open-aiq/hardware/pcb/proto2/fab/proto2-bom.csv

Reference | Value | Part | Footprint | Qty | Datasheet
C1 | 100uF | 100 µF electrolytic, ≥10 V, 6.3 mm radial, 2.5 mm pitch | Capacitor_THT:CP_Radial_D6.3mm_P2.50mm | 1
C2,C4 | 100nF | 100 nF ceramic, 5 mm pitch | Capacitor_THT:C_Disc_D5.0mm_W2.5mm_P5.00mm | 2
C3 | 10uF | 10 µF electrolytic, ≥10 V, 5 mm radial, 2 mm pitch | Capacitor_THT:CP_Radial_D5.0mm_P2.00mm | 1
J1 | PMS5003 | Molex PicoBlade 53047-0810, 8-pin 1.25 mm vertical header | Connector_Molex:Molex_PicoBlade_53047-0810_1x08_P1.25mm_Vertical | 1
J2 | OLED_SH1106 | 1×4 female header, 2.54 mm, for a 1.3 in SH1106 128×64 I2C OLED module | Connector_PinSocket_2.54mm:PinSocket_1x04_P2.54mm_Vertical | 1
J3 | SHT30 | 1×4 + 1×2 female header, 2.54 mm, for an SHT30 breakout (4 + 2 pins) | open-aiq:SHT30_Module_Socket_4+2 | 1
R1,R2 | 4.7k | 4.7 kΩ resistor, 1/4 W axial | Resistor_THT:R_Axial_DIN0207_L6.3mm_D2.5mm_P10.16mm_Horizontal | 2
R3,R4 | 10k | 10 kΩ resistor, 1/4 W axial | Resistor_THT:R_Axial_DIN0207_L6.3mm_D2.5mm_P10.16mm_Horizontal | 2
SW1 | Right | 6×6 mm THT tactile switch, 4-leg (e.g. Omron B3F-1000) | Button_Switch_THT:SW_PUSH_6mm | 1
SW2 | Left | 6×6 mm THT tactile switch, 4-leg (e.g. Omron B3F-1000) | Button_Switch_THT:SW_PUSH_6mm | 1
SW3 | Pair | 6×6 mm THT tactile switch, 4-leg (e.g. Omron B3F-1000) | Button_Switch_THT:SW_PUSH_6mm | 1
U1 | ESP32-S3-DevKitC-1 | 2 × 1×22 female header, 2.54 mm, 25.4 mm apart, for an ESP32-S3-DevKitC-1 | open-aiq:ESP32-S3-DevKitC-1_Socket | 1 | https://docs.espressif.com/projects/esp-dev-kits/en/latest/esp32s3/esp32-s3-devkitc-1/user_guide.html
