open-aiq/hardware/pcb/proto2/proto2-assembly.pdf

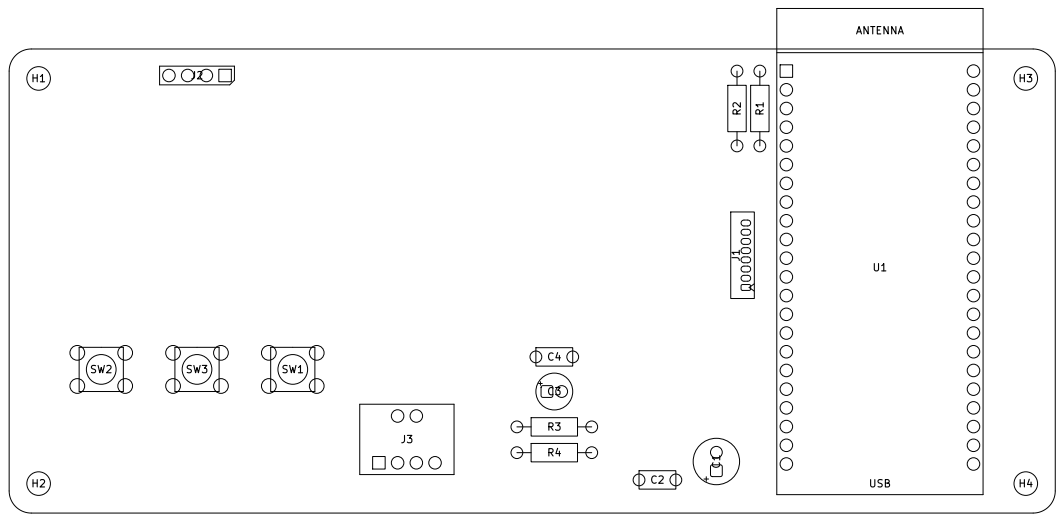
[picture p4: page 1]

Size: A4 | Rev:
KiCad E.D.A. 10.0.8 | Id: 1/1
