open-aiq/hardware/pcb/proto2/proto2.pdf

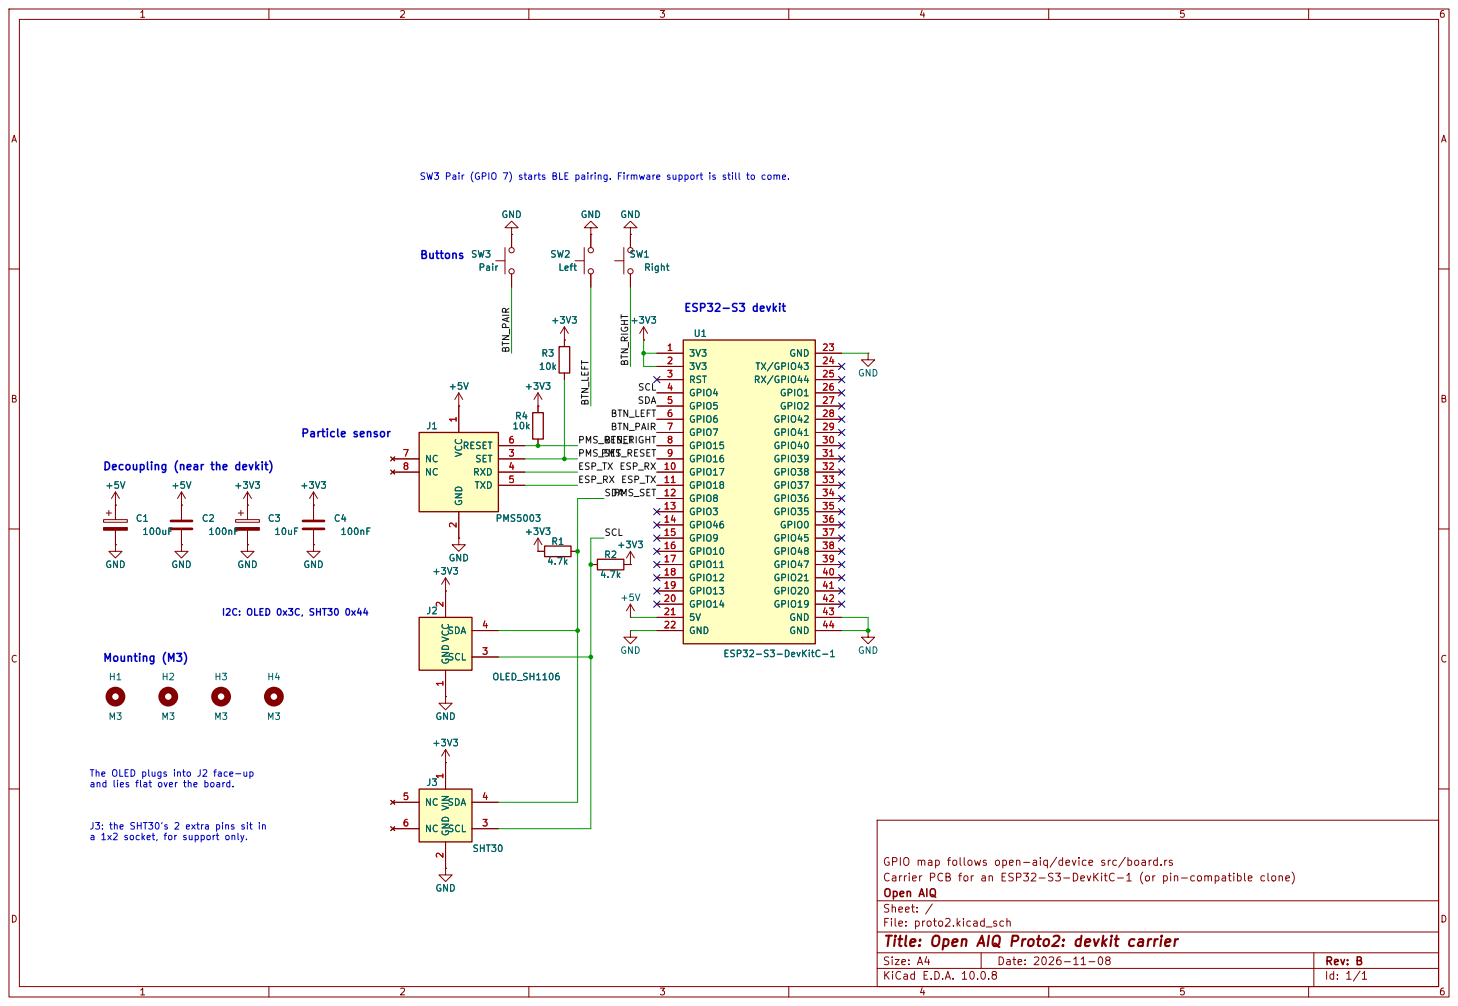
[picture p5: page 1]

SDAPMS_SET ESP_TX PMS_RESET ESP_RX PMS_SET BTN_RIGHT Decoupling (near the devkit)

The OLED plugs into J2 face-up
and lies flat over the board. J3: the SHT30's 2 extra pins sit in

1 GND
GPIO map follows open-aiq/device src/board.rs VIN

a 1x2 socket, for support only.

Carrier PCB for an ESP32-S3-DevKitC-1 (or pin-compatible clone)
Open AIQ
Sheet: /
File: proto2.kicad_sch
Title: Open AIQ Proto2: devkit carrier

Size: A4 | Rev: B
KiCad E.D.A. 10.0.8 | Id: 1/1
