open-aiq/hardware/pcb/proto2/proto2.kicad_pcb

## KiCad design pcb/proto2/proto2.kicad_pcb (2026-11-09)

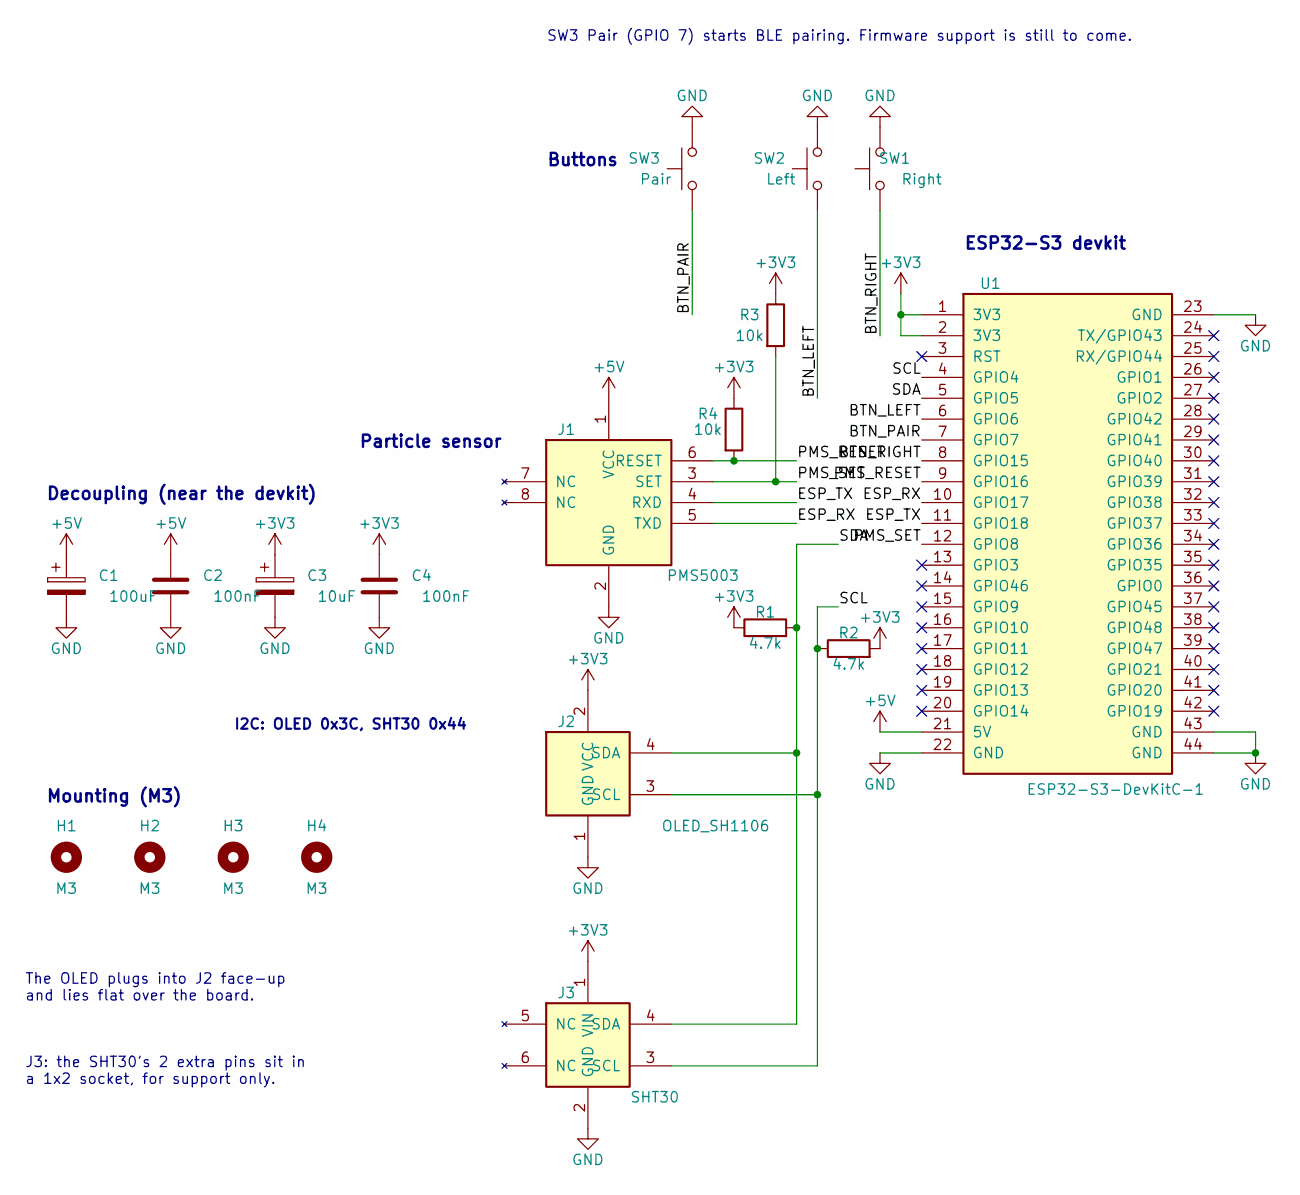
[picture p6: schematic proto2.kicad_sch, Open AIQ Proto2: devkit carrier]

Parts:
C1: 100uF; CP_Radial_D6.3mm_P2.50mm; Part 100 µF electrolytic, ≥10 V, 6.3 mm radi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
C2, C4: 100nF; C_Disc_D5.0mm_W2.5mm_P5.00mm; Part 100 nF ceramic, 5 mm pitch
C3: 10uF; CP_Radial_D5.0mm_P2.00mm; Part 10 µF electrolytic, ≥10 V, 5 mm radial,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
H1, H2, H3, H4: M3; MountingHole_3.2mm_M3; Part M3 mounting hole
J1: PMS5003; Molex_PicoBlade_53047-0810_1x08_P1.25mm_Vertical; Part Molex PicoBlade 53047-0810, 8-pin 1.25 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
J2: OLED_SH1106; PinSocket_1x04_P2.54mm_Vertical; Part 1×4 female header, 2.54 mm, for a 1.3 i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
J3: SHT30; SHT30_Module_Socket_4+2; Part 1×4 + 1×2 female header, 2.54 mm, for a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
R1, R2: 4.7k; R_Axial_DIN0207_L6.3mm_D2.5mm_P10.16mm_Horizontal; Part 4.7 kΩ resistor, 1/4 W axial
R3, R4: 10k; R_Axial_DIN0207_L6.3mm_D2.5mm_P10.16mm_Horizontal; Part 10 kΩ resistor, 1/4 W axial
SW1: Right; SW_PUSH_6mm; Part 6×6 mm THT tactile switch, 4-leg (e.g. 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
SW2: Left; SW_PUSH_6mm; Part 6×6 mm THT tactile switch, 4-leg (e.g. 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
SW3: Pair; SW_PUSH_6mm; Part 6×6 mm THT tactile switch, 4-leg (e.g. 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
U1: ESP32-S3-DevKitC-1; ESP32-S3-DevKitC-1_Socket; Part 2 × 1×22 female header, 2.54 mm, 25.4 m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

Connections:
+3V3: C3.1, C4.1, J2.2 (VCC), J3.1 (VIN), R1.1, R2.2, R3.1, R4.1, U1.1 (3V3), U1.2 (3V3)
+5V: C1.1, C2.1, J1.1 (VCC), U1.21 (5V)
/BTN_LEFT: SW2.1, U1.6 (GPIO6)
/BTN_PAIR: SW3.1, U1.7 (GPIO7)
/BTN_RIGHT: SW1.1, U1.8 (GPIO15)
/ESP_RX: J1.5 (TXD), U1.10 (GPIO17)
/ESP_TX: J1.4 (RXD), U1.11 (GPIO18)
/PMS_RESET: J1.6 (RESET), R4.2, U1.9 (GPIO16)
/PMS_SET: J1.3 (SET), R3.2, U1.12 (GPIO8)
/SCL: J2.3 (SCL), J3.3 (SCL), R2.1, U1.4 (GPIO4)
/SDA: J2.4 (SDA), J3.4 (SDA), R1.2, U1.5 (GPIO5)
GND: C1.2, C2.2, C3.2, C4.2, J1.2 (GND), J2.1 (GND), J3.2 (GND), SW1.2, SW2.2, SW3.2, U1.22 (GND), U1.23 (GND), U1.43 (GND), U1.44 (GND)

Notes on the sheet:
I2C: OLED 0x3C, SHT30 0x44
ESP32-S3 devkit
SW3 Pair (GPIO 7) starts BLE pairing. Firmware support is still to come.
The OLED plugs into J2 face-up and lies flat over the board.
J3: the SHT30's 2 extra pins sit in a 1x2 socket, for support only.
Buttons
Decoupling (near the devkit)
Particle sensor
Mounting (M3)

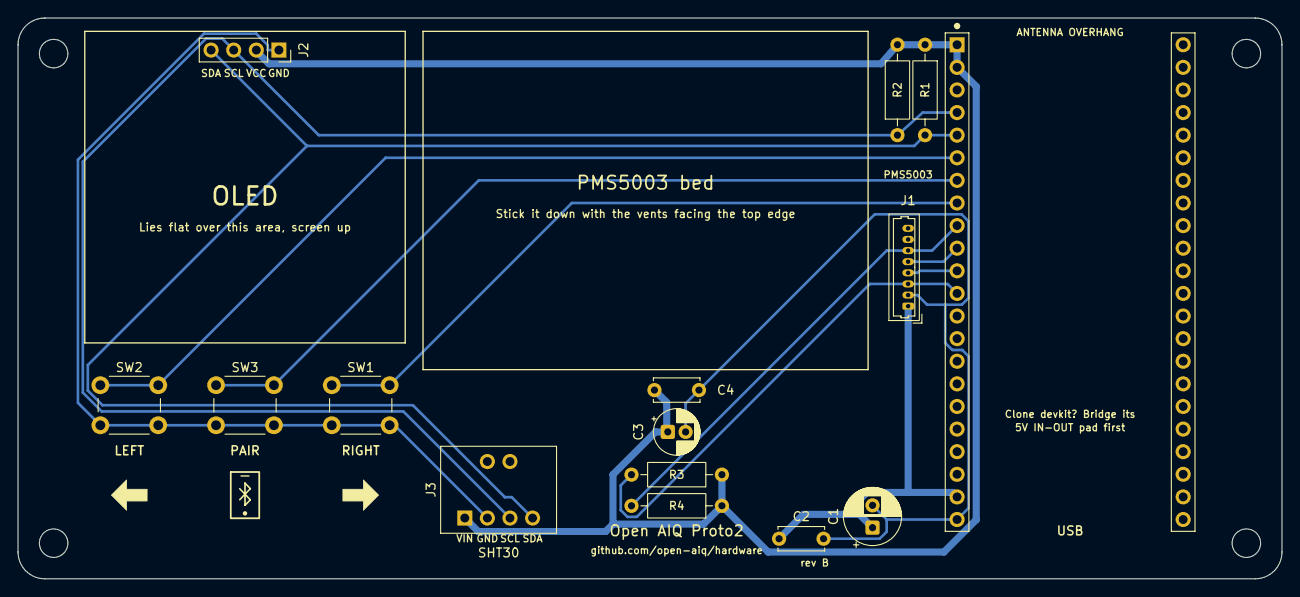
[picture p7: board proto2.kicad_pcb from above]

Board: 2 copper layers, 142.0 x 63.0 mm, 22 parts (0 on the bottom side), 12 nets.

Other parts of the board:
G_SW1: Icon_Arrow_Right
G_SW2: Icon_Arrow_Left
G_SW3: Icon_Phone_Bluetooth
