open-aiq/hardware/(commit log)

2026-11-08 feat(proto2): add devkit carrier PCB
    Prototype 2 carrier for the ESP32-S3-DevKitC-1 (and pin-compatible
    clones), with PMS5003, OLED and SHT30 connectors, two buttons and I2C
    pull-ups. Pins match src/board.rs in open-aiq/device; PMS5003 SET and
    RESET are wired to GPIO 16 and 15 with pull-ups so current firmware
    runs unchanged.
    - KiCad 10 project, ERC/DRC clean with schematic parity
    - Shared open-aiq symbol and footprint library in lib/
    - Gerbers, drill, BOM, schematic PDF and 3D renders
    - scripts/export.sh regenerates outputs after checks pass
    [proto2-B_Cu.gbl, proto2-B_Mask.gbs, proto2-B_Paste.gbp, proto2-B_Silkscreen.gbo, proto2-Edge_Cuts.gm1, proto2-F_Cu.gtl, proto2-F_Mask.gts, proto2-F_Paste.gtp]
2026-11-08 chore: make the boards easy to work on in KiCad
    - Add proto2.kicad_jobset: ERC, DRC, schematic PDF, assembly drawing,
    Gerbers, drill and BOM, all runnable from KiCad's GUI
    - scripts/export.sh now runs the board's jobset, then zips Gerbers,
    writes a JLCPCB-format CPL (when there is a placement file) and renders
    - Save the Proto2 schematic in KiCad 10's native format so the first save
    in KiCad doesn't rewrite the file
    - Ignore jobset check reports; README gains a "Working in KiCad" guide
    [proto2-B_Cu.gbl, proto2-B_Mask.gbs, proto2-B_Paste.gbp, proto2-B_Silkscreen.gbo, proto2-Edge_Cuts.gm1, proto2-F_Cu.gtl, proto2-F_Mask.gts, proto2-F_Paste.gtp]
2026-11-09 chore: ignore KiCad local history
2026-11-09 feat(proto2): rev B, single-sided with a pair button and the new pin map
    All copper is on the bottom layer now. The OLED sits top-left with three
    buttons under it (right, left and a pair button on GPIO 7), the sensors take
    the middle and the devkit's USB faces the bottom edge. Pins moved to make
    the single layer work: I2C on GPIO 5/4, PMS5003 UART on 18/17, SET on 8 and
    buttons on 15/6, matching src/board.rs in open-aiq/device. Fab outputs,
    BOM, PDFs and renders are regenerated.
    [proto2-B_Cu.gbl, proto2-B_Mask.gbs, proto2-B_Paste.gbp, proto2-B_Silkscreen.gbo, proto2-Edge_Cuts.gm1, proto2-F_Cu.gtl, proto2-F_Mask.gts, proto2-F_Paste.gtp]
2026-11-11 docs(readme): describe the folders that exist today
    The layout table listed an SMT board, a battery revision and an enclosure
    that aren't on main, and promised a bring-up checklist. They're now under
    "still to come".
